immarianaas/iot-bling-bling/esp32/lorawan/lorawan.ino

/*
 * Author: JP Meijers
 * Date: 2016-10-20
 *
 * Transmit a one byte packet via TTN. This happens as fast as possible, while still keeping to
 * the 1% duty cycle rules enforced by the RN2483's built in LoRaWAN stack. Even though this is
 * allowed by the radio regulations of the 868MHz band, the fair use policy of TTN may prohibit this.
 *
 * CHECK THE RULES BEFORE USING THIS PROGRAM!
 *
 * CHANGE ADDRESS!
 * Change the device address, network (session) key, and app (session) key to the values
 * that are registered via the TTN dashboard.
 * The appropriate line is "myLora.initABP(XXX);" or "myLora.initOTAA(XXX);"
 * When using ABP, it is advised to enable "relax frame count".
 *
 * Connect the RN2xx3 as follows:
 * RN2xx3 -- ESP8266
 * Uart TX -- GPIO4
 * Uart RX -- GPIO5
 * Reset -- GPIO15
 * Vcc -- 3.3V
 * Gnd -- Gnd
 *
 */
#include <rn2xx3.h>
#include <HardwareSerial.h>

HardwareSerial mySerial(2); // Using UART 1

#define RXD2 16   // UART RX
#define TXD2 17   // UART TX
#define RESET 23  // pin connected to RST of RN2483 

rn2xx3 myLora(mySerial);

// the setup routine runs once when you press reset:
void setup() {
  // LED pin is GPIO2 which is the ESP8266's built in LED
  pinMode(2, OUTPUT);
  led_on();

  // Open serial communications and wait for port to open:
  Serial.begin(115200);
  mySerial.setRxBufferSize(1024);
  mySerial.begin(57600, SERIAL_8N1, RXD2, TXD2);
  mySerial.setTimeout(1000);  // define a timeout in ms to wait for serial data

  delay(1000); //wait for the arduino ide's serial console to open

  Serial.println("Startup");

  initialize_radio();

  //transmit a startup message
  myLora.tx("TTN Mapper on ESP8266 node");

  led_off();
  delay(2000);
}

void initialize_radio()
{
  //reset RN2xx3
  pinMode(RESET, OUTPUT);
  digitalWrite(RESET, LOW);
  delay(100);
  digitalWrite(RESET, HIGH);

  delay(100); //wait for the RN2xx3's startup message
  mySerial.flush();

  //check communication with radio
  String hweui = myLora.hweui();
  while(hweui.length() != 16)
  {
    Serial.println("Communication with RN2xx3 unsuccessful. Power cycle the board.");
    Serial.println(hweui);
    delay(10000);
    hweui = myLora.hweui();
  }

  //print out the HWEUI so that we can register it via ttnctl
  Serial.println("When using OTAA, register this DevEUI: ");
  Serial.println(hweui);
  Serial.println("RN2xx3 firmware version:");
  Serial.println(myLora.sysver());

  //configure your keys and join the network
  Serial.println("Trying to join TTN");
  bool join_result = false;

  //ABP: initABP(String addr, String AppSKey, String NwkSKey);
  //join_result = myLora.initABP("02017201", "8D7FFEF938589D95AAD928C2E2E7E48F", "AE17E567AECC8787F749A62F5541D522");

  //OTAA: initOTAA(String AppEUI, String AppKey);
  join_result = myLora.initOTAA("BE7A00000000164F", "97283F8F8A54765C8AE759F152613D7B"); //, "0004A30B010651F7");

  while(!join_result)
  {
    Serial.println("Unable to join. Are your keys correct, and do you have TTN coverage?");
    delay(10000); //delay a minute before retry
    join_result = myLora.init();
  }
  Serial.println("Successfully joined TTN");

}

// the loop routine runs over and over again forever:
void loop() {
    led_on();

    Serial.println("TXing");
    myLora.tx("mar"); // blocking function

    String str = myLora.getRx();
    Serial.print("String received: ");
    Serial.println(str);

    led_off();
    delay(2000);
}

void led_on()
{
  digitalWrite(2, 1);
}

void led_off()
{
  digitalWrite(2, 0);
}
