immarianaas/iot-bling-bling/(commit log)

2025-04-16 light control file with sensors
2025-04-24 replaced tap with button
    [light_control.ino]
2025-04-26 Battery code
2025-05-04 Updated battery code
2025-05-04 Light control with interrupts
2025-05-05 create libraries battery and light control
2025-05-12 light and battery
2025-05-12 redesign light control library
    [my_light_control.cpp, my_light_control.h]
2025-05-12 changes before soldering
2025-05-17 Changes to battery
2025-05-25 accelerometer library added
